lhtlove/SonicFlow-Scanner/(list of files, cad)

Other CAD files:
full_design.step
01-motion-shell/1. model/motion_shell.step
02-carriage-module/1. model/module.step
