lhtlove/SonicFlow-Scanner/02-carriage-module/2. hardware/module_controller.pdf

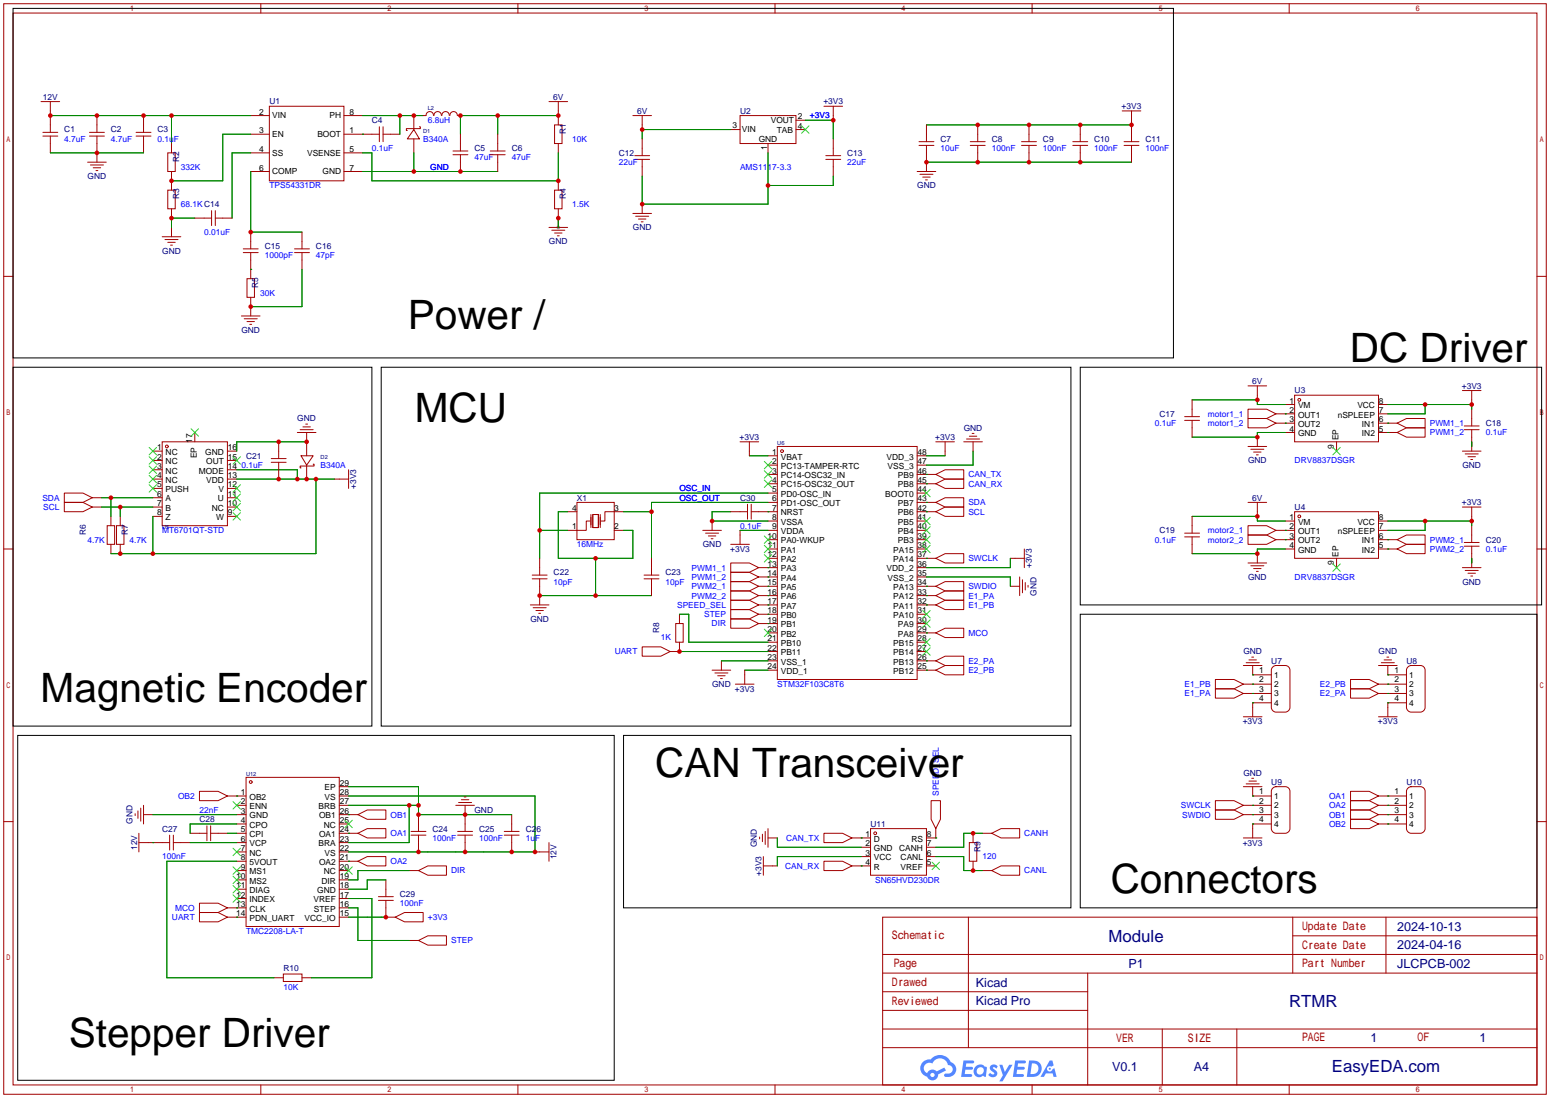
[picture p36: page 1]

12 VDD 13 MODE 14 OUT 15 GND 16
