lhtlove/SonicFlow-Scanner/01-motion-shell/2. hardware/stepper_controller.pdf

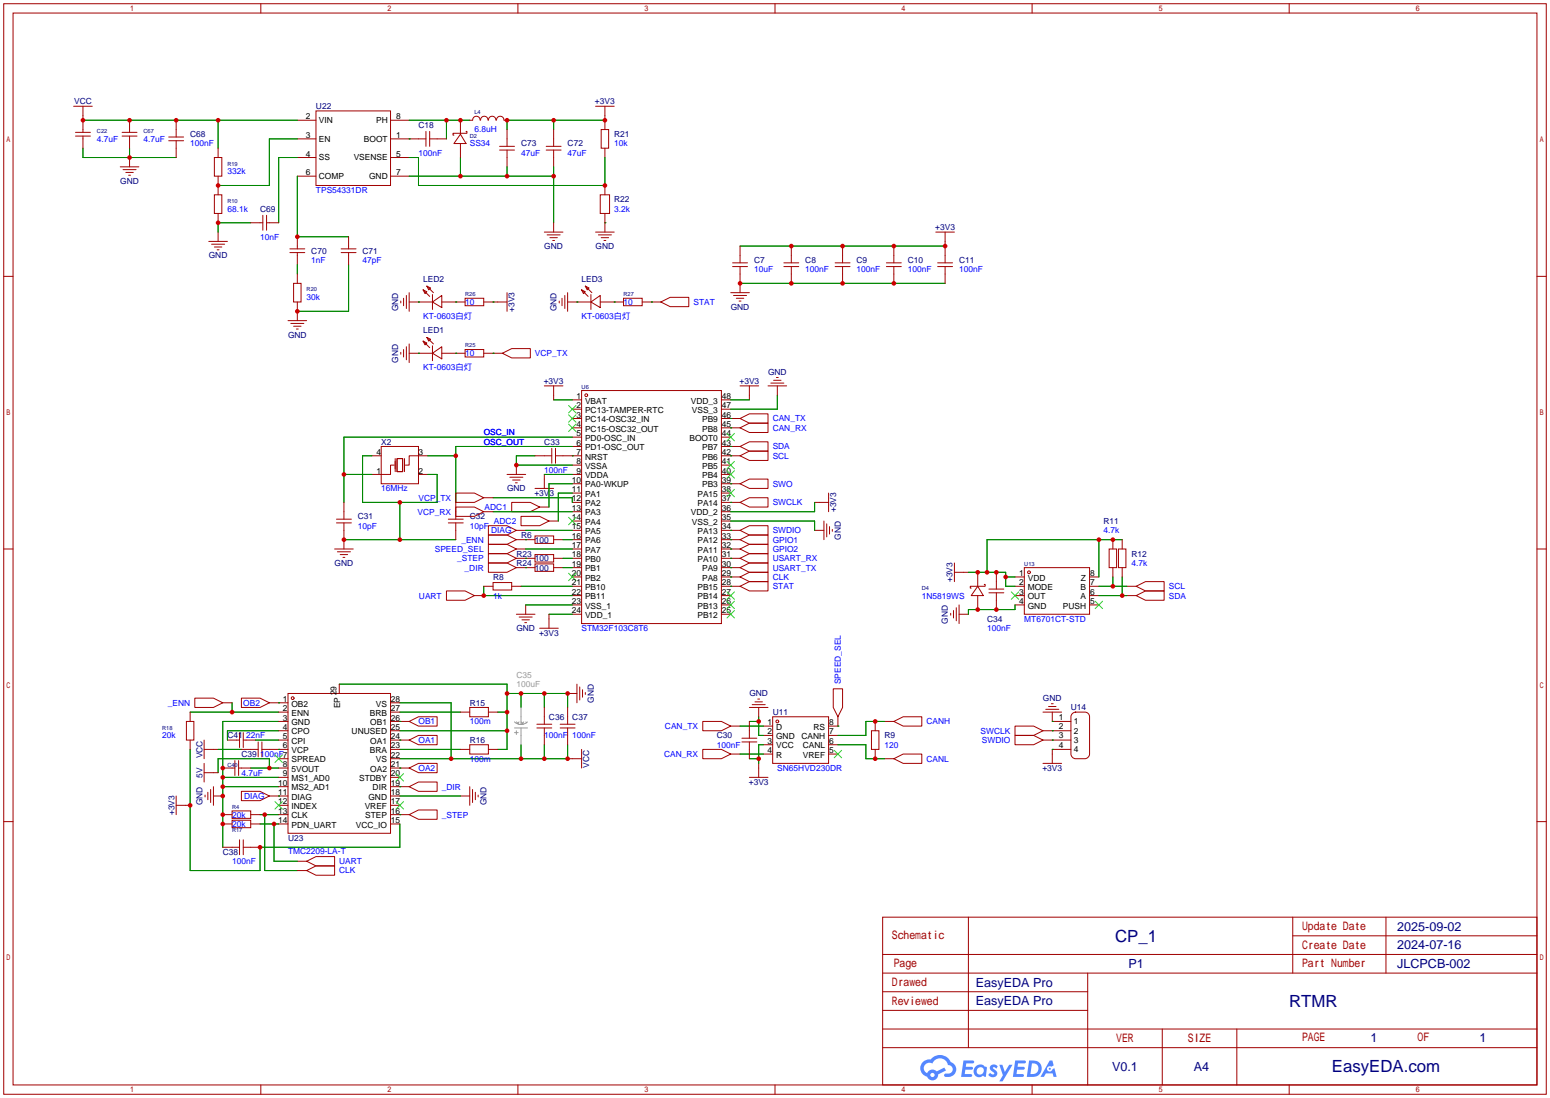
[picture p37: page 1]
