lhtlove/SonicFlow-Scanner/03-sensor/1. hardware/sensor_module.pdf

# Negative Reference

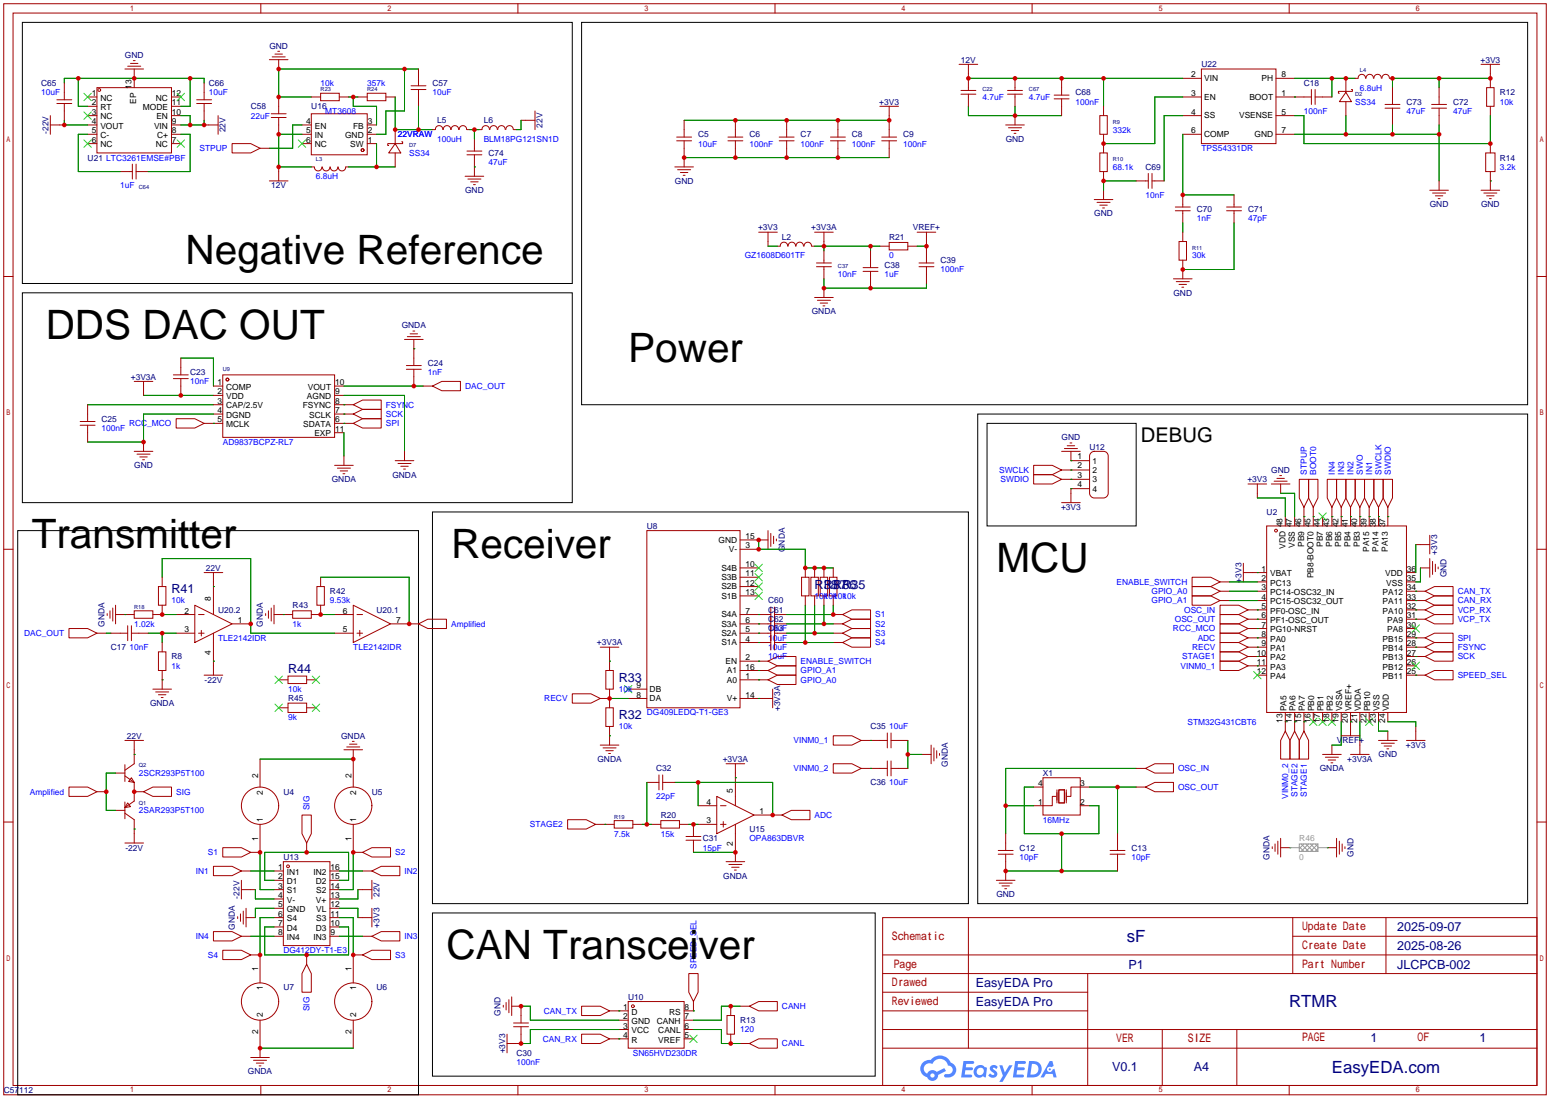
[picture p38: page 1]
