lhtlove/SonicFlow-Scanner/02-carriage-module/3. firmware/SMC/Core/Src/main.cpp

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
/* Includes ------------------------------------------------------------------*/
#include "main.h"
#include "math.h"
//
//M_PI

/* USER CODE BEGIN Includes */

#include "stepper_setting.hpp"
#include "motors.hpp"
#include "can.hpp"
#include "encoders.hpp"
#include "smc.hpp"

/* USER CODE END Includes */

/* USER CODE BEGIN PD */

#define SYSCLK 64000000

/* USER CODE END PD */

CAN_HandleTypeDef hcan;

I2C_HandleTypeDef hi2c1;
DMA_HandleTypeDef hdma_i2c1_rx;

TIM_HandleTypeDef htim1;
TIM_HandleTypeDef htim2;
TIM_HandleTypeDef htim3;
TIM_HandleTypeDef htim4;

UART_HandleTypeDef huart3;

/* USER CODE BEGIN PV */

uint16_t E1_last = 0;
uint16_t E2_last = 0;

uint32_t speedLE = 0, speedRE = 0;

/* USER CODE END PV */

void SystemClock_Config(void);
static void MX_GPIO_Init(void);
static void MX_DMA_Init(void);
static void MX_I2C1_Init(void);
static void MX_CAN_Init(void);
static void MX_USART3_UART_Init(void);
static void MX_TIM1_Init(void);
static void MX_TIM2_Init(void);
static void MX_TIM3_Init(void);
static void MX_TIM4_Init(void);
/* USER CODE BEGIN PFP */

#define MT6701_ADDR (0x06 << 1)  // Default slave address 0x06 shifted for HAL
#define REG_ANGLE_HIGH 0x03
#define REG_ANGLE_LOW 0x04

/* USER CODE END PFP */

/* USER CODE BEGIN 0 */
uint32_t speedTim(uint8_t id) {
	return ((id ? speedRE : speedLE) > __HAL_TIM_GET_COUNTER(&htim2) ?
			__HAL_TIM_GET_COUNTER(&htim2) + 65536 :
			__HAL_TIM_GET_COUNTER(&htim2)) - (id ? speedRE : speedLE);
}

void separate_float(float value, uint8_t* integer_part, uint8_t* decimal_part) {
    // Extract integer part
    *integer_part = (uint8_t)value;

    // Extract 2 decimal digits
    float decimal_temp = (value - (int)value) * 100;
    *decimal_part = (uint8_t)decimal_temp;
}
/* USER CODE END 0 */

/**
  * @brief  The application entry point.
  * @retval int
  */
int main(void)
{

  /* MCU Configuration--------------------------------------------------------*/

  /* Reset of all peripherals, Initializes the Flash interface and the Systick. */
  HAL_Init();

  /* Configure the system clock */
  SystemClock_Config();

  /* Initialize all configured peripherals */
  MX_GPIO_Init();
  MX_DMA_Init();
  MX_I2C1_Init();
  MX_CAN_Init();
  MX_USART3_UART_Init();
  MX_TIM1_Init();
  MX_TIM2_Init();
  MX_TIM3_Init();
  MX_TIM4_Init();
  /* USER CODE BEGIN 2 */

  HAL_TIM_Base_Start(&htim2);

  stpSetting_init(&huart3);
  gconfSetup(global_config_);
  cconfSetup(chopper_config_, 0b0011);
  currentSetup(driver_current_, 0, current);

  Stepper_Init(&htim1);
  Stepper_SetSpeed(30);

  DC_Init(&htim3, 0);
  DC_Init(&htim4, 1);

  CAN_INIT(&hcan, DEVICE_ID, MASK_SINGLE);

  /* USER CODE END 2 */

//	  stepper_angle = stepper_encoder_angle(&hi2c1, RAD);
  uint8_t E1A, E1B, E2A, E2B;
  uint8_t curE1, curE2, lastE1 = 0, lastE2 = 0;
  uint8_t replyData[8];

  uint64_t start;
  uint8_t dc_flag = 0;

//  static uint16_t enc_div = 0;
//  uint16_t enc_before = 0;
//  uint8_t on_run = 0;

  while (1) {
//	if (++enc_div >= 0) {
//		enc_div = 0;
//
//		stepper_encoder_angle(DEG);
//		increment = abs(raw_angle - enc_before);
//
//		if (stepper.is_running) on_run = 1;
//		else if (on_run && increment <= 10) {
//			Stepper_Stop();
//			on_run = 0;
//
//			replyData[0] = 0x30;
//			packFloat(404.404, replyData + 1);
//			CAN_Tx(replyData, 8, DEVICE_MASTER);
//		} else if (on_run) {
//			replyData[0] = 0x30;
//			packFloat(increment, replyData + 1);
//			CAN_Tx(replyData, 8, DEVICE_MASTER);
//		}
////		replyData[0] = 0x30;
////		packFloat(increment, replyData + 1);
////		CAN_Tx(replyData, 8, DEVICE_MASTER);
//
//		enc_before = raw_angle;
//	}

	E1A = HAL_GPIO_ReadPin(E1_A_GPIO_Port, E1_A_Pin);
	E1B = HAL_GPIO_ReadPin(E1_B_GPIO_Port, E1_B_Pin);
	curE1 = (E1A << 1) | E1B;

	E2A = HAL_GPIO_ReadPin(E2_A_GPIO_Port, E2_A_Pin);
	E2B = HAL_GPIO_ReadPin(E2_B_GPIO_Port, E2_B_Pin);
	curE2 = (E2A << 1) | E2B;

	if(curE1 != lastE1) {
		switch((lastE1 << 2) | curE1) {
		  case 0b0010:
		  case 0b1011:
		  case 0b1101:
		  case 0b0100:
			DCL.countE--;
			DCL.error = -(DCL.counts_to_go - DCL.countE);

			if (DCL.is_running && !DCL.dir) {
				DCL.speedE = speedTim(0);
				speedLE = __HAL_TIM_GET_COUNTER(&htim2);

				if ((DCL.counts_going) / 4 - 5 <= DCL.counts_going - DCL.error
						&& DCL.counts_going - DCL.error < (DCL.counts_going) / 4 + 5) {
					DCL.sum += DCL.speedE;
				} else if (DCL.counts_going - DCL.error == (DCL.counts_going) / 4 + 5) {
					spd = DCL.sum / 10;
					spdFlag = 1;
				}
			}

			break;

		  case 0b0001:
		  case 0b0111:
		  case 0b1110:
		  case 0b1000:
			DCL.countE++;
			DCL.error = (DCL.counts_to_go - DCL.countE);

//			DCL.speedE = __HAL_TIM_GET_COUNTER(&htim2);
//			__HAL_TIM_SET_COUNTER(&htim2, 0);

			if (DCL.is_running && DCL.dir) {
				DCL.speedE = speedTim(0);
				speedLE = __HAL_TIM_GET_COUNTER(&htim2);

				if ((DCL.counts_going) / 4 - 5 <= DCL.counts_going - DCL.error
						&& DCL.counts_going - DCL.error < (DCL.counts_going) / 4 + 5) {
					DCL.sum += DCL.speedE;
				} else if (DCL.counts_going - DCL.error == (DCL.counts_going) / 4 + 5) {
					spd = DCL.sum / 10;
					spdFlag = 1;
				}

				if (DCL.speedE <= 160 && accelCnt < 5) accelCnt++;
				if (accelCnt == 5) {
					accel = DCL.counts_going - DCL.error;
					accelCnt++;
				}
			}

			break;
		} lastE1 = curE1;
	}

	if(curE2 != lastE2) {
		switch((lastE2 << 2) | curE2) {
		  case 0b0010:
		  case 0b1011:
		  case 0b1101:
		  case 0b0100:
			DCR.countE++;
			DCR.error = (DCR.counts_to_go - DCR.countE);

			if (DCR.is_running && DCR.dir) {
				DCR.speedE = speedTim(1);
				speedRE = __HAL_TIM_GET_COUNTER(&htim2);

				if ((DCR.counts_going) / 4 - 5 <= DCR.counts_going - DCR.error
						&& DCR.counts_going - DCR.error < (DCR.counts_going) / 4 + 5) {
					DCR.sum += DCR.speedE;
				} else if (DCR.counts_going - DCR.error == (DCR.counts_going) / 4 + 5) {
					spd = DCR.sum / 10;
					spdFlag = 1;
				}
			}

			break;

		  case 0b0001:
		  case 0b0111:
		  case 0b1110:
		  case 0b1000:
			DCR.countE--;
			DCR.error = -(DCR.counts_to_go - DCR.countE);

			if (DCR.is_running && !DCR.dir) {
				DCR.speedE = speedTim(1);
				speedRE = __HAL_TIM_GET_COUNTER(&htim2);

				if ((DCR.counts_going) / 4 - 5 <= DCR.counts_going - DCR.error
						&& DCR.counts_going - DCR.error < (DCR.counts_going) / 4 + 5) {
					DCR.sum += DCR.speedE;
				} else if (DCR.counts_going - DCR.error == (DCR.counts_going) / 4 + 5) {
					spd = DCR.sum / 10;
					spdFlag = 1;
				}
			}

			break;
		} lastE2 = curE2;
	}



	if (DCL.stopped == -1 && speedTim(0) > 20000) {
		DCL.stopped = 1;

		if (dcl_program) dc_placed(0);
		if (swap == SWAP) dc_orient(target_ori);
//		send_int16(DCL.counts_going - DCL.error, replyData + 2);
	}

	if (DCR.stopped == -1 && speedTim(1) > 20000) {
		DCR.stopped = 1;

		if (dcr_program) dc_placed(1);
		if (swap == SWAP) dc_orient(target_ori);
	}

	if (phase != HOMING_DONE && DCL.stopped && DCR.stopped && !dc_flag) {
		start = HAL_GetTick();
		dc_flag = 1;
	} if (dc_flag && HAL_GetTick() - start > 100) {
		dc_flag = 0;
		dc_home();
	}

  }
}

void HAL_TIM_PeriodElapsedCallback(TIM_HandleTypeDef *htim) {
	if (htim -> Instance == stepper.htim_stepper -> Instance) Stepper_TIM_Interrupt();
    else if(htim -> Instance == DCL.htim_dc -> Instance) DC_TIM_Interrupt(&DCL);
    else if(htim -> Instance == DCR.htim_dc -> Instance) DC_TIM_Interrupt(&DCR);
}

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
