lhtlove/SonicFlow-Scanner/03-sensor/2. firmware/sonicFlow/sonicFlow.ioc

Mcu.UserName=STM32G431CBTx
PA0.Signal=ADC1_IN1
PA1.GPIO_Label=OPAMP_IN
PA1.Signal=OPAMP1_VINP
PA10.Signal=USART1_RX
PA11.GPIO_Label=CAN_RX
PA11.Signal=FDCAN1_RX
PA12.GPIO_Label=CAN_TX
PA12.Signal=FDCAN1_TX
PA13.Signal=SYS_JTMS-SWDIO
PA14.Signal=SYS_JTCK-SWCLK
PA15.Signal=GPIO_Output
PA2.Signal=OPAMP1_VOUT
PA3.Signal=OPAMP1_VINM0
PA4.Signal=GPIO_Output
PA5.Signal=OPAMP2_VINM0
PA6.Signal=OPAMP2_VOUT
PA7.Signal=OPAMP2_VINP
PA9.Signal=USART1_TX
PB11.GPIO_Label=CAN_SPEED
PB11.Signal=GPIO_Output
PB13.GPIO_Label=FG_FCK
PB13.Signal=SPI2_SCK
PB14.GPIO_Label=FG_FSYNC
PB14.Signal=GPIO_Output
PB15.GPIO_Label=FG_SPI
PB15.Signal=SPI2_MOSI
PB3.Signal=SYS_JTDO-SWO
PB4.GPIO_Label=SEL_IN2
PB4.Signal=GPIO_Output
PB5.GPIO_Label=SEL_IN3
PB5.Signal=GPIO_Output
PB6.GPIO_Label=SEL_IN4
PB6.Signal=GPIO_Output
PB9.Signal=GPIO_Output
PC13.GPIO_Label=RECV_EN
PC13.Signal=GPIO_Output
PC14-OSC32_IN.GPIO_Label=RECV_A0
PC14-OSC32_IN.Signal=GPIO_Output
PC15-OSC32_OUT.GPIO_Label=RECV_A1
PC15-OSC32_OUT.Signal=GPIO_Output
PF0-OSC_IN.Signal=RCC_OSC_IN
PF1-OSC_OUT.Signal=RCC_OSC_OUT
PG10-NRST.Signal=RCC_MCO
