lhtlove/SonicFlow-Scanner/03-sensor/2. firmware/sonicFlow/Core/Src/main.c

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
/* Includes ------------------------------------------------------------------*/
#include "main.h"

/* USER CODE BEGIN Includes */

#include "can.h"
#include "stdio.h"
#include "string.h"
#include "sF.h"

/* USER CODE END Includes */

ADC_HandleTypeDef hadc1;

FDCAN_HandleTypeDef hfdcan1;

OPAMP_HandleTypeDef hopamp1;
OPAMP_HandleTypeDef hopamp2;

SPI_HandleTypeDef hspi2;

TIM_HandleTypeDef htim1;
TIM_HandleTypeDef htim2;
TIM_HandleTypeDef htim6;

UART_HandleTypeDef huart1;

/* USER CODE BEGIN PV */

#define RX_BUFFER_SIZE 100
uint8_t rx_buffer[RX_BUFFER_SIZE];
uint8_t rx_index = 0;
uint8_t rx_data;
char received_string[RX_BUFFER_SIZE];
volatile uint8_t string_received = 0;

/* USER CODE END PV */

void SystemClock_Config(void);
static void MX_GPIO_Init(void);
static void MX_ADC1_Init(void);
static void MX_FDCAN1_Init(void);
static void MX_OPAMP1_Init(void);
static void MX_OPAMP2_Init(void);
static void MX_SPI2_Init(void);
static void MX_TIM1_Init(void);
static void MX_TIM6_Init(void);
static void MX_USART1_UART_Init(void);
static void MX_TIM2_Init(void);
/* USER CODE BEGIN PFP */

int __io_putchar(int ch) {
	HAL_UART_Transmit(&huart1, (uint8_t*)&ch, 1, HAL_MAX_DELAY);
	return ch;
}

/* USER CODE END PFP */

/**
  * @brief  The application entry point.
  * @retval int
  */
int main(void)
{

  /* MCU Configuration--------------------------------------------------------*/

  /* Reset of all peripherals, Initializes the Flash interface and the Systick. */
  HAL_Init();

  /* Configure the system clock */
  SystemClock_Config();

  /* Initialize all configured peripherals */
  MX_GPIO_Init();
  MX_ADC1_Init();
  MX_FDCAN1_Init();
  MX_OPAMP1_Init();
  MX_OPAMP2_Init();
  MX_SPI2_Init();
  MX_TIM1_Init();
  MX_TIM6_Init();
  MX_USART1_UART_Init();
  MX_TIM2_Init();
  /* USER CODE BEGIN 2 */

//  HAL_GPIO_WritePin(SEL_IN1_GPIO_Port, SEL_IN1_Pin, GPIO_PIN_RESET);
//  HAL_GPIO_WritePin(SEL_IN2_GPIO_Port, SEL_IN2_Pin, GPIO_PIN_RESET);
//  HAL_GPIO_WritePin(SEL_IN3_GPIO_Port, SEL_IN3_Pin, GPIO_PIN_RESET);
//  HAL_GPIO_WritePin(SEL_IN4_GPIO_Port, SEL_IN4_Pin, GPIO_PIN_SET);
  DDS_Off();

  if (DEVICE_ID & 1) {
	  DDS_Init();
	  HAL_GPIO_WritePin(SEL_IN4_GPIO_Port, SEL_IN4_Pin, GPIO_PIN_SET);
	  HAL_GPIO_WritePin(RECV_EN_GPIO_Port, RECV_EN_Pin, GPIO_PIN_RESET);

	  HAL_GPIO_WritePin(GPIOB, GPIO_PIN_9, GPIO_PIN_SET);
  } else {
	  DDS_Sleep();

	  HAL_GPIO_WritePin(RECV_EN_GPIO_Port, RECV_EN_Pin, GPIO_PIN_SET);
	  HAL_GPIO_WritePin(RECV_A0_GPIO_Port, RECV_A0_Pin, GPIO_PIN_RESET);
	  HAL_GPIO_WritePin(RECV_A1_GPIO_Port, RECV_A1_Pin, GPIO_PIN_RESET);

	  HAL_OPAMP_Start(&hopamp1);
	  HAL_OPAMP_Start(&hopamp2);

	  HAL_GPIO_WritePin(GPIOB, GPIO_PIN_9, GPIO_PIN_RESET);
  }

  HAL_TIM_Base_Start(&htim1);

  HAL_UART_Receive_IT(&huart1, &rx_data, 1);
  CAN_INIT(DEVICE_ID, MASK_SINGLE);


  while(HAL_ADCEx_Calibration_Start(&hadc1, ADC_SINGLE_ENDED) != HAL_OK);
  uint8_t Data[8];

  uint16_t value, voltage;

//  Ultrasonic_SendBurst(10000);

  /* USER CODE END 2 */

  /* Infinite loop */
  /* USER CODE BEGIN WHILE */
  while (1) {
//      HAL_ADC_Start(&hadc1);
//      if (HAL_ADC_PollForConversion(&hadc1, HAL_MAX_DELAY) == HAL_OK) {
//          value = HAL_ADC_GetValue(&hadc1);
//          voltage = (value * 3300.0f) / 4095.0f;
//      } HAL_ADC_Stop(&hadc1);
//      printf("%d\n", voltage);

//	    if (string_received)
//	    {
//	        // Process the received string
//	        printf("Received: %s\r\n", received_string);
//
//	        // Example: Check for specific commands
//	        if (strcmp(received_string, "tog") == 0) {
//	        	Data[0] = 0x40;
//	        	CAN_Tx(Data, 8, DEVICE_MASTER);
//	        }
//
//
//	        if (strcmp(received_string, "oi") == 0)
//			{
//	        	DDS_On();
//	        	sineWave(CalcFTW(300000));
//			} else if (strcmp(received_string, "ofi") == 0)
//			{
//				DDS_Off();
//			}
//
//	        if (strcmp(received_string, "sm") == 0) {
//	        	Ultrasonic_StartMeasurement();
//	        }
//
//
//	        // Clear the flag
//	        string_received = 0;
//	    }
//
////	  printf("hi\n");
////
////	    Ultrasonic_SendBurst(10000);
//    	Data[0] = 0x40;
//    	CAN_Tx(Data, 8, DEVICE_MASTER);
//	    HAL_Delay(100);

    /* USER CODE END WHILE */

    /* USER CODE BEGIN 3 */
  }
  /* USER CODE END 3 */
}

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
/* USER CODE BEGIN 4 */
uint16_t i = 10;
uint8_t Data[8] = {0x01, 0x01};

void HAL_TIM_PeriodElapsedCallback(TIM_HandleTypeDef *htim) {
	if (htim -> Instance == TIM6) {
		send_int32(i++, Data + 2);
		CAN_Tx(Data, 8, 0x003);
	}
}

/* USER CODE BEGIN 4 */
void HAL_UART_RxCpltCallback(UART_HandleTypeDef *huart)
{
    if (huart->Instance == USART1)
    {
        // Check for end of string (newline or carriage return)
        if (rx_data == '\n' || rx_data == '\r')
        {
            // Null terminate the string
            rx_buffer[rx_index] = '\0';

            // Copy to received_string buffer
            strcpy((char*)received_string, (char*)rx_buffer);

            // Set flag that string is received
            string_received = 1;

            // Reset buffer index
            rx_index = 0;
        }
        else
        {
            // Add character to buffer if there's space
            if (rx_index < (RX_BUFFER_SIZE - 1))
            {
                rx_buffer[rx_index++] = rx_data;
            }
            else
            {
                // Buffer overflow - reset
                rx_index = 0;
            }
        }

        // Re-enable interrupt for next character
        HAL_UART_Receive_IT(&huart1, &rx_data, 1);
    }
}
/* USER CODE END 4 */
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
