lhtlove/SonicFlow-Scanner/03-sensor/2. firmware/sonicFlow/Core/Inc/main.h

#define RECV_EN_Pin GPIO_PIN_13
#define RECV_EN_GPIO_Port GPIOC
#define RECV_A0_Pin GPIO_PIN_14
#define RECV_A0_GPIO_Port GPIOC
#define RECV_A1_Pin GPIO_PIN_15
#define RECV_A1_GPIO_Port GPIOC
#define OPAMP_IN_Pin GPIO_PIN_1
#define OPAMP_IN_GPIO_Port GPIOA
#define CAN_SPEED_Pin GPIO_PIN_11
#define CAN_SPEED_GPIO_Port GPIOB
#define FG_FCK_Pin GPIO_PIN_13
#define FG_FCK_GPIO_Port GPIOB
#define FG_FSYNC_Pin GPIO_PIN_14
#define FG_FSYNC_GPIO_Port GPIOB
#define FG_SPI_Pin GPIO_PIN_15
#define FG_SPI_GPIO_Port GPIOB
#define CAN_RX_Pin GPIO_PIN_11
#define CAN_RX_GPIO_Port GPIOA
#define CAN_TX_Pin GPIO_PIN_12
#define CAN_TX_GPIO_Port GPIOA
#define SEL_IN2_Pin GPIO_PIN_4
#define SEL_IN2_GPIO_Port GPIOB
#define SEL_IN3_Pin GPIO_PIN_5
#define SEL_IN3_GPIO_Port GPIOB
#define SEL_IN4_Pin GPIO_PIN_6
#define SEL_IN4_GPIO_Port GPIOB
