lhtlove/SonicFlow-Scanner/(commit log)

2025-11-24 Add comprehensive CLAUDE.md documentation for AI assistants
    - Document dual STM32 microcontroller architecture (F1 + G4)
    - Explain motor control system and peripheral drivers
    - Detail STM32CubeMX integration patterns and USER CODE sections
    - Provide hardware specifications and peripheral configurations
    - Include development workflows and common task guides
    - Add debugging tips and critical warnings for embedded development
2026-01-12 Create docs directory structure for project documentation
    - Add docs/images/ for README.md photos and renders
    - Add docs/schematics/ for circuit diagrams
    - Add docs/technical-notes/ for design documentation
    - Include README.md in images/ with upload guidelines
2026-01-12 Move outdated firmware and peripheral code to legacy directory
    - Move Core_SMC, Core_SonicFlow, and peripheral_SMC into legacy/
    - Keep .ioc files inside their respective Core directories
    - Clean root directory structure for future hardware/firmware organization
    The legacy directory contains the initial proof-of-concept firmware:
    - Core_SMC: STM32F103 carriage controller (with SMC.ioc)
    - Core_SonicFlow: STM32G431 sensor board (with Sonic Flow.ioc)
    - peripheral_SMC: Motor and CAN peripheral drivers
2026-01-12 Add README.md to legacy directory explaining outdated code
    - Document purpose of legacy directory
    - Explain what each subdirectory contains
    - Provide context for why code is preserved
    - Direct developers to current active development
    - Include references to key legacy implementations
2026-01-12 Create main project directory structure
    - Add hardware/ with mechanical and electronics subdirectories
    - mechanical: motion-shell, carriage-module, sensor-housing
    - electronics: carriage-controller, sensor-board, slip-ring
    - Add firmware/ for embedded code
    - carriage-controller: STM32F103 motion control
    - sensor-module: STM32G431 ultrasonic TX/RX
    - shared: Common libraries and CAN protocol
    - Add software/ for host applications
    - reconstruction: Tomographic algorithms
    - host: PC control interface
    - Add bom/ for bill of materials
    Directory structure now matches README.md documentation.
2026-01-12 Revert "Delete legacy directory"
    This reverts commit 676d3863749f09b7fc1ef2f50c600fc63d155069.
    [SMC.ioc, Sonic Flow.ioc, can.cpp, can.hpp, encoders.cpp, encoders.hpp, main.c, main.cpp]
2026-01-12 Replace hardware/firmware structure with project module directories
    - Remove hardware/ and firmware/ directory structure
    - Create module-based directories:
    - motion-shell/: Motion system components
    - carriage-module/: Carriage and positioning
    - sensor/: Ultrasonic sensor module
    - assembly/: Assembly guides and documentation
    Simpler structure organized by physical modules rather than file types.
2026-01-12 Remove bom directory and add numbered prefixes for logical ordering
    - Remove bom/ directory
    - Rename directories with number prefixes for logical ordering:
    - 01-motion-shell: Motion system components
    - 02-carriage-module: Carriage and positioning
    - 03-sensor: Ultrasonic sensor module
    - 04-assembly: Assembly guides and documentation
    - 05-docs: Project documentation
    - 06-legacy: Outdated proof-of-concept code
    Directories now display in logical order regardless of alphabetical sorting.
2026-01-12 Add subdirectory structure and documentation to project modules
    - Add hardware/, firmware/, model/ subdirectories to each module
    - Create comprehensive README.md for each module:
    - 01-motion-shell: Shell specs, slip rings, assembly
    - 02-carriage-module: Motors, encoders, custom algorithms
    - 03-sensor: DDS, amplifiers, signal processing
    - 04-assembly: Build order, tools, troubleshooting
    Each README documents specifications, features, and directory contents.
2026-01-12 Add .gitignore for motion shell firmware directory
    Ignore build artifacts and temporary files:
    - Build outputs (Debug/, Release/, *.o, *.elf, *.hex, etc.)
    - IDE metadata (.settings/, .metadata/, .project, .cproject)
    - STM32CubeMX temp files (.mxproject)
    - OS-specific files (.DS_Store, Thumbs.db)
    - Editor backup files
2026-01-12 Add firmware .gitignore to remaining module directories
    Applied the same firmware-specific .gitignore pattern to:
    - 02-carriage-module/firmware/
    - 03-sensor/firmware/
    - 04-assembly/firmware/
    This ensures consistent exclusion of build artifacts, IDE metadata,
    and system files across all firmware directories.
2026-01-14 upload a large model file for motion-shell
    [Ultimate Device.step]
2026-01-14 Rename Ultimate Device.step to motion_shell.step
    [motion_shell.step]
2026-01-14 Rename motion_shell.step to 1. motion_shell.step
    [1. motion_shell.step]
2026-01-15 Rename 1. motion_shell.step to motion_shell.step
    [motion_shell.step]
2026-01-15 Update module model
    [module.step]
2026-01-15 Upload the full model to assembly directory
    [full_design.step]
2026-01-16 Update hardware files for carriage module
2026-01-16 Update hardware files for sensor dir
2026-01-16 Add interactive 3D assembly viewer link
    Added Autodesk 360 link in System Architecture section for interactive
    3D visualization of the full assembly design.
2026-01-16 Move 3D assembly link next to project overview
    Consolidated both reference links (documentation and 3D viewer) at the
    top of README for easier access. Removed duplicate 3D link from System
    Architecture section.
2026-01-18 Remove assembly directory
    [full_design.step]
2026-01-21 add temp readme for carriage module
2026-01-21 update sensor dir readme
2026-01-21 update sensor readme
