lhtlove/SonicFlow-Scanner/(notices)

Notices in the files:
03-sensor/2. firmware/sonicFlow/Core/Inc/main.h:
Copyright (c) 2024 STMicroelectronics.
All rights reserved.
This software is licensed under terms that can be found in the LICENSE file
README.md:
License: CC BY-NC-ND 4.0
